squawki/esp32-cpu-ram-gauges/gauge_templates/readme.txt

Image files you can edit, print out, cut out as required
