squawki/esp32-cpu-ram-gauges/gauge_templates/gauge_cpu.jpeg

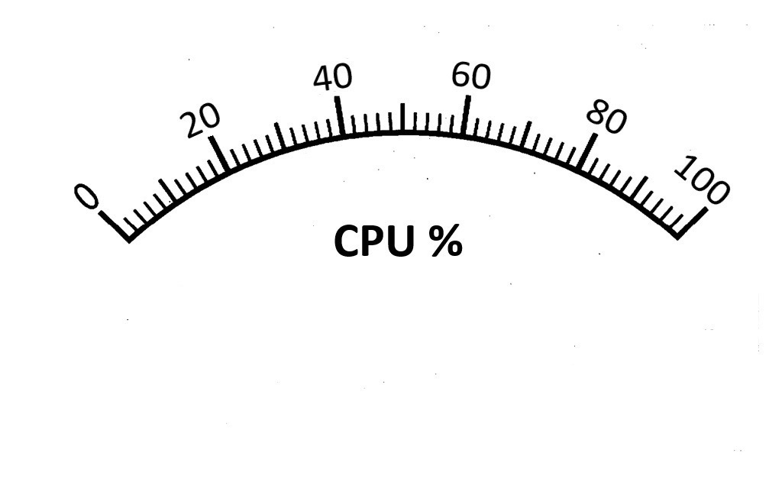
gauge_templates/gauge_cpu.jpeg
