squawki/esp32-cpu-ram-gauges/(commit log)

2026-10-07 Initial ESP32 sketch and linux script
2026-10-07 Upload of gauges in operation and the ESP32-C3
